yosoy2/prensa_gemela/fotos/Ensamble3.png

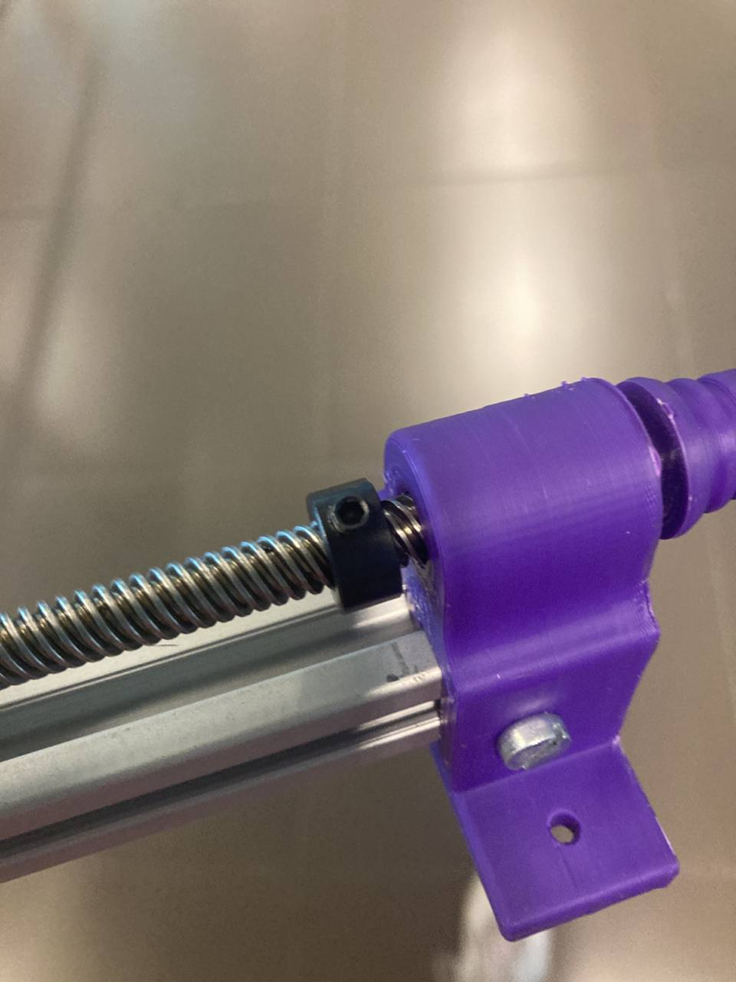
fotos/Ensamble3.png
