yosoy2/prensa_gemela/fotos/Ensamble.png

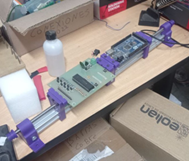
fotos/Ensamble.png
