yosoy2/prensa_gemela/fotos/Impresion1.png

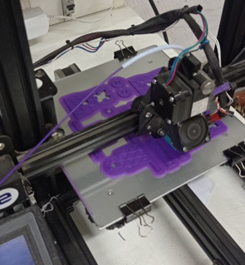
fotos/Impresion1.png
