yosoy2/prensa_gemela/fotos/Impresion2.png

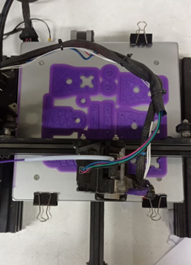
fotos/Impresion2.png
