yosoy2/prensa_gemela/fotos/prensa_gemela.PNG

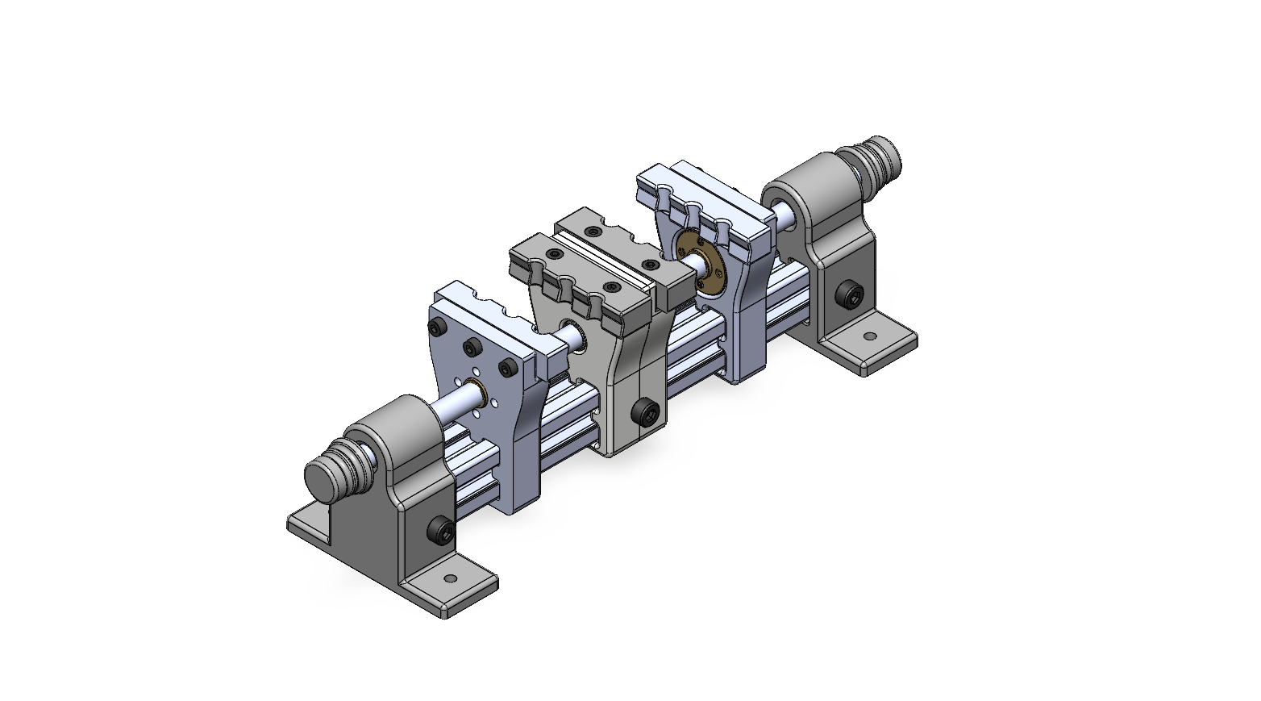
fotos/prensa_gemela.PNG
