yosoy2/prensa_gemela/fotos/prensa_gemela_grande.PNG

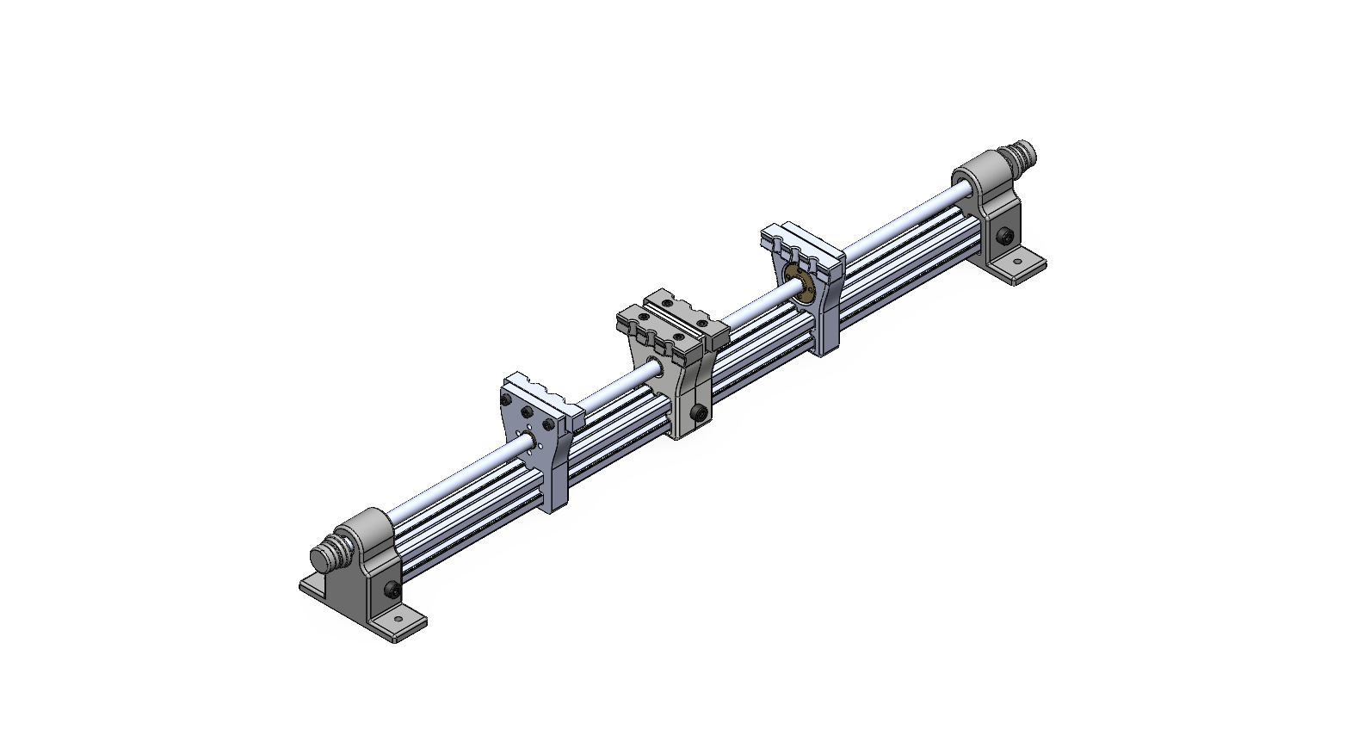
fotos/prensa_gemela_grande.PNG
