yosoy2/prensa_gemela/fotos/Programa segmentacion1.png

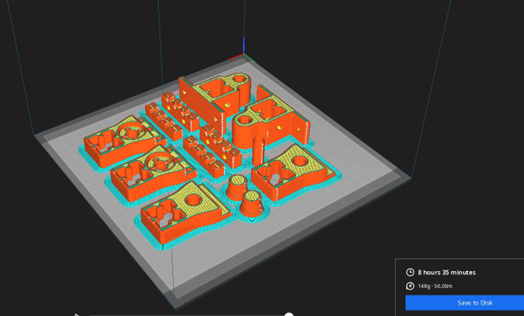
fotos/Programa segmentacion1.png
