yosoy2/prensa_gemela/fotos/Programa segmentación2.png

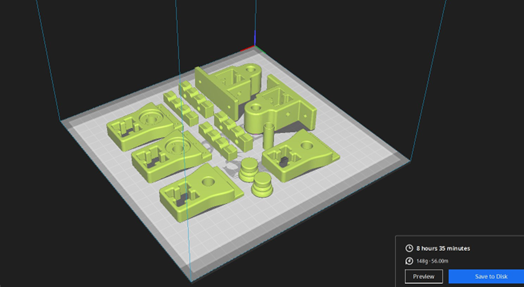
fotos/Programa segmentación2.png
