yosoy2/prensa_gemela/BOM.pdf

N.º DE ELEMENTO | N.º DE PIEZA | DESCRIPCIÓN | CANTIDAD
1 | perfil_guia | | 2
2 | Tornillo_tr8 | | 2
3 | 005359_Tuerca_de_lat ón_para_varilla_rosca da_husillo_Tr8_8_p2 | | 2
4 | mandibula_movil | | 2
5 | diente_2 | | 2
6 | mandibula_fija | | 2
7 | diente_2_fijo | | 2
8 | Base_Prensa | | 2
9 | buje | | 1
10 | Manivela | | 2
11 | M3_socket_10mm | | 6
12 | M3_socket_16mm | | 4
13 | M5_allen_socket_10m m | | 4
14 | T_Slot_Nut_Dropin_202 0 m5 v2 | | 4
15 | M5_allen_socket_45 | | 1
16 | M5_nut | | 1
