yosoy2/prensa_gemela/CAD/test.SLDASM

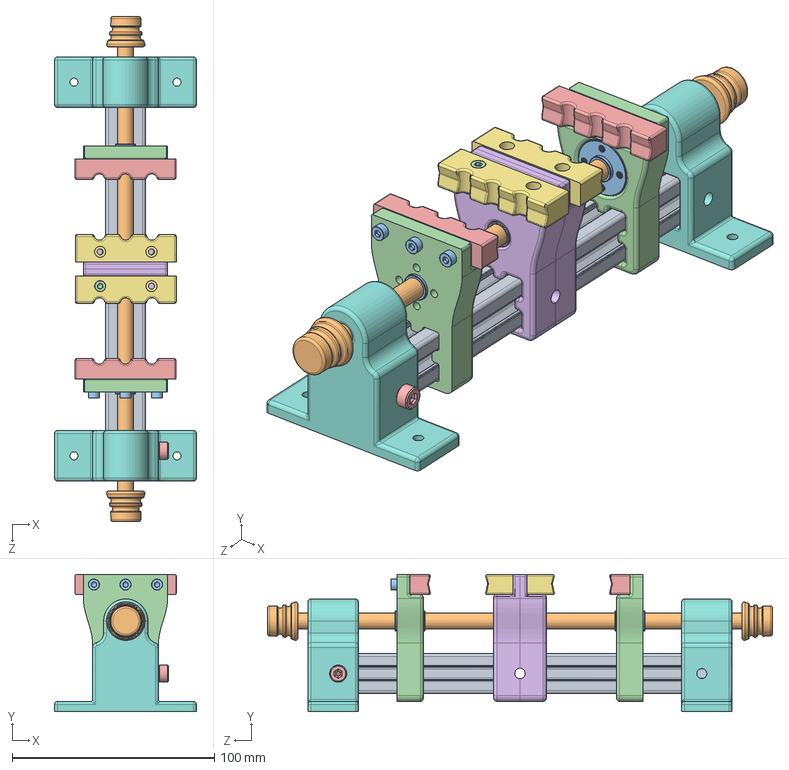
[picture p10: CAD file, 2022-12-02]
CAD/test.SLDASM
70.3 x 67.8 x 250.0 mm
perfil_guia x 2
Tornillo_tr8 x 2
005359_Tuerca_de_latón_para_varilla_roscada_husillo_Tr8_8_p2 x 2
mandibula_movil x 2
diente_2 x 2
mandibula_fija x 2
diente_2_fijo x 2
Base .step x 2
Buje_circular.step
Componente1.step x 2
M3_socket_10mm x 3
M3_socket_16mm
M5_allen_socket_10mm
T_Slot_Nut_Dropin_2020 m5 v2
