yosoy2/prensa_gemela/CAD/M3_socket_10mm.SLDPRT

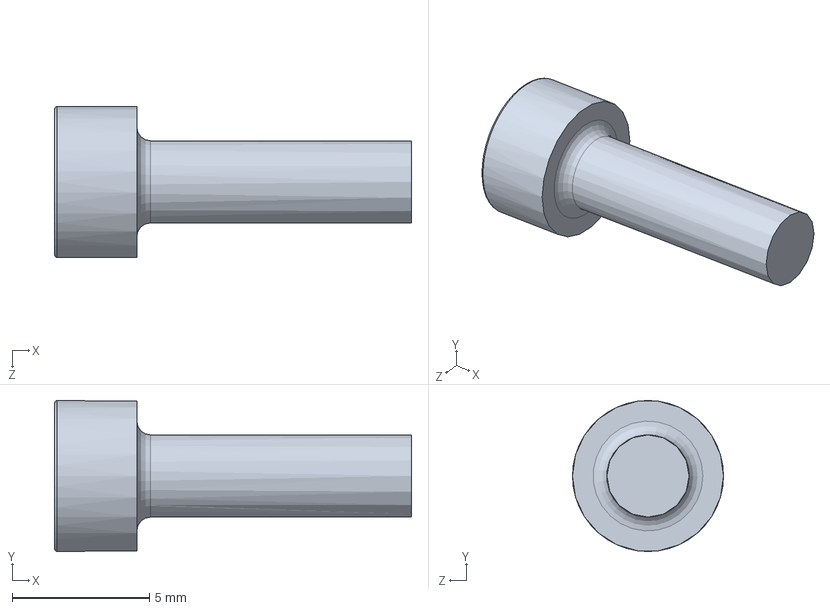
[picture p11: CAD file, 2022-12-02]
CAD/M3_socket_10mm.SLDPRT
13.0 x 5.50 x 5.50 mm
