yosoy2/prensa_gemela/para_impresion/diente_mandibula_fija.stl

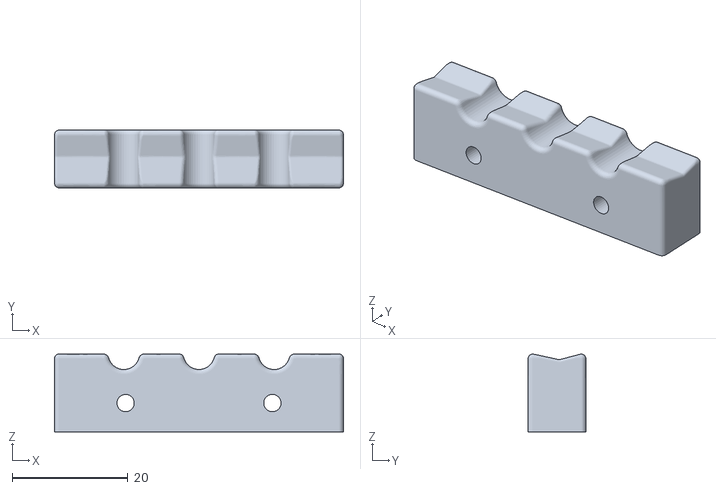
[picture p12: CAD file, 2022-12-02]
para_impresion/diente_mandibula_fija.stl
50.0 x 10.0 x 13.5
