yosoy2/prensa_gemela/step/perfil_guia.STEP

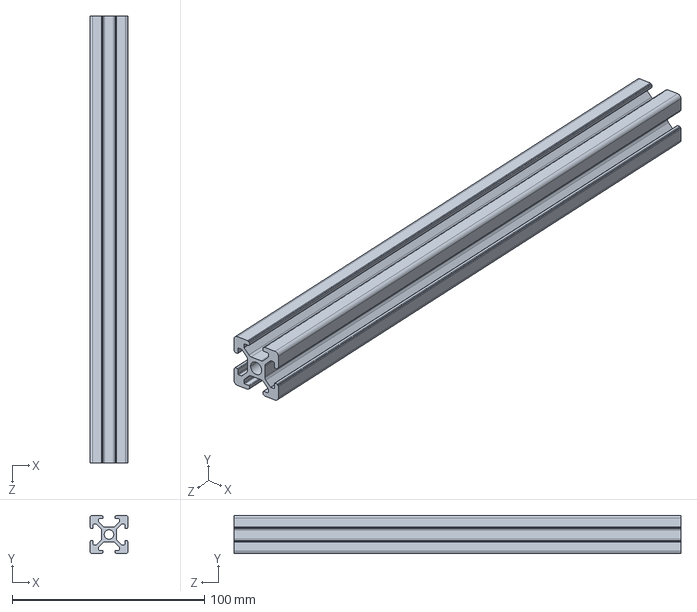
[picture p13: CAD file, 2022-12-02]
step/perfil_guia.STEP
20.0 x 20.0 x 232.5 mm
