yosoy2/prensa_gemela/test/test_buje.SLDPRT

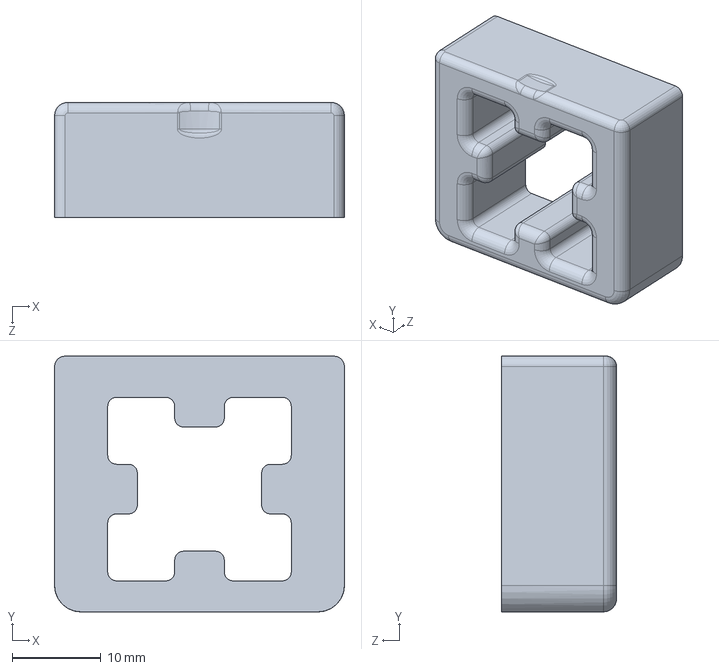
[picture p14: CAD file, 2022-12-02]
test/test_buje.SLDPRT
32.7 x 28.8 x 13.0 mm
