yosoy2/prensa_gemela/para_impresion/prensa_gemela.3mf

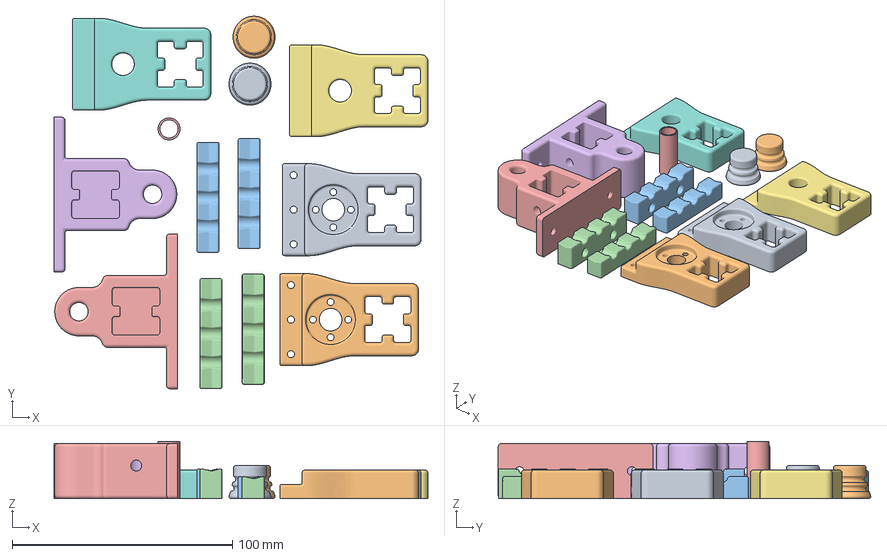
[picture p15: CAD file, 2022-12-02]
para_impresion/prensa_gemela.3mf
169.7 x 169.1 x 26.0 mm
mandibula_movil.STL
mandibula_movil.STL(1)
diente_2.STL
diente_2.STL(1)
Base Prensa_Base v1.stl
Base Prensa_Base v1.stl(1)
mandibula_fija_media.STL
mandibula_fija_media.STL(1)
Manivela v1.stl
Manivela v1.stl(1)
diente_mandibula_fija.stl
diente_mandibula_fija.stl(1)
buje_mandibula_fija.stl
