yosoy2/prensa_gemela/CAD/mandibula_movil.SLDPRT

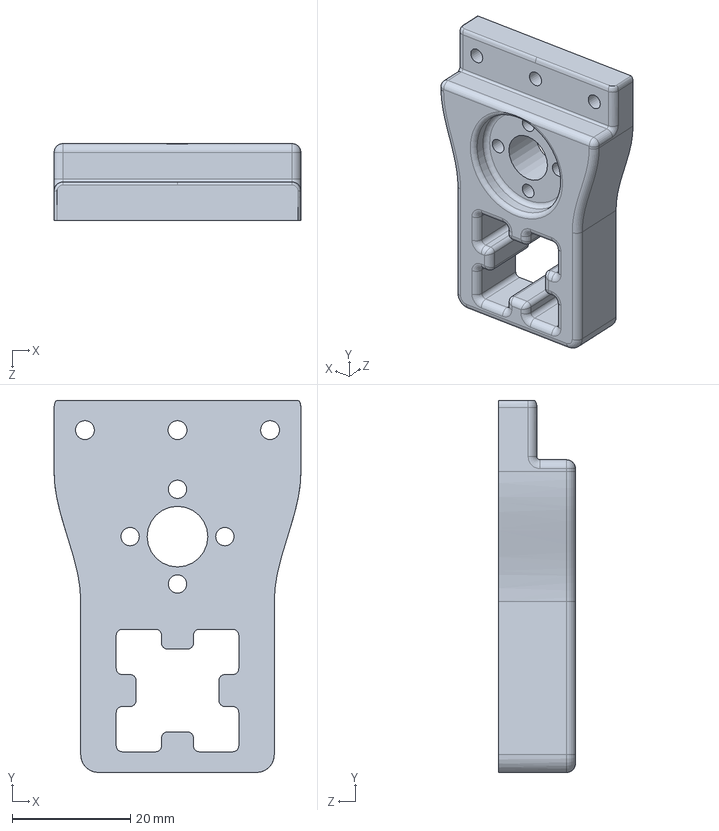
[picture p16: CAD file, 2022-12-02]
CAD/mandibula_movil.SLDPRT
41.7 x 62.8 x 13.0 mm
