yosoy2/prensa_gemela/para_impresion/Base Prensa_Base v1.stl

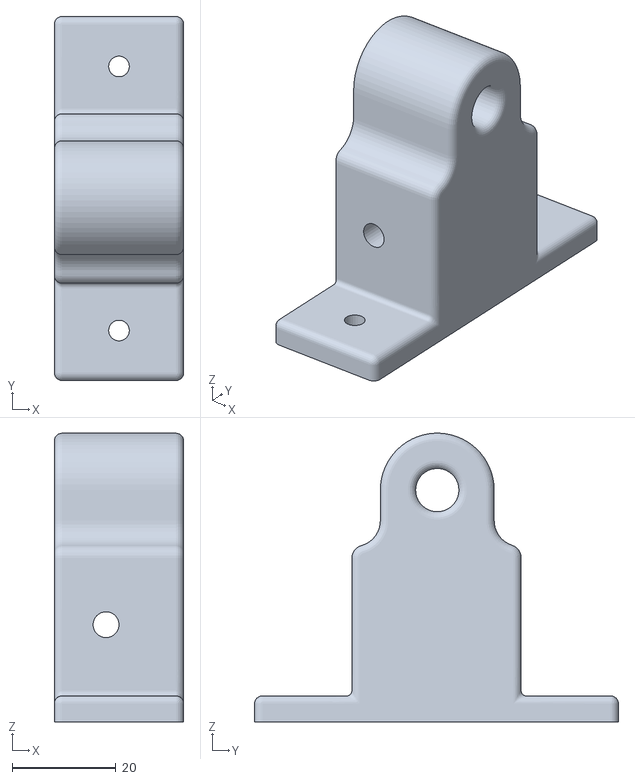
[picture p17: CAD file, 2022-12-02]
para_impresion/Base Prensa_Base v1.stl
25.0 x 70.3 x 55.7
