yosoy2/prensa_gemela/step/mandibula_movile.STEP

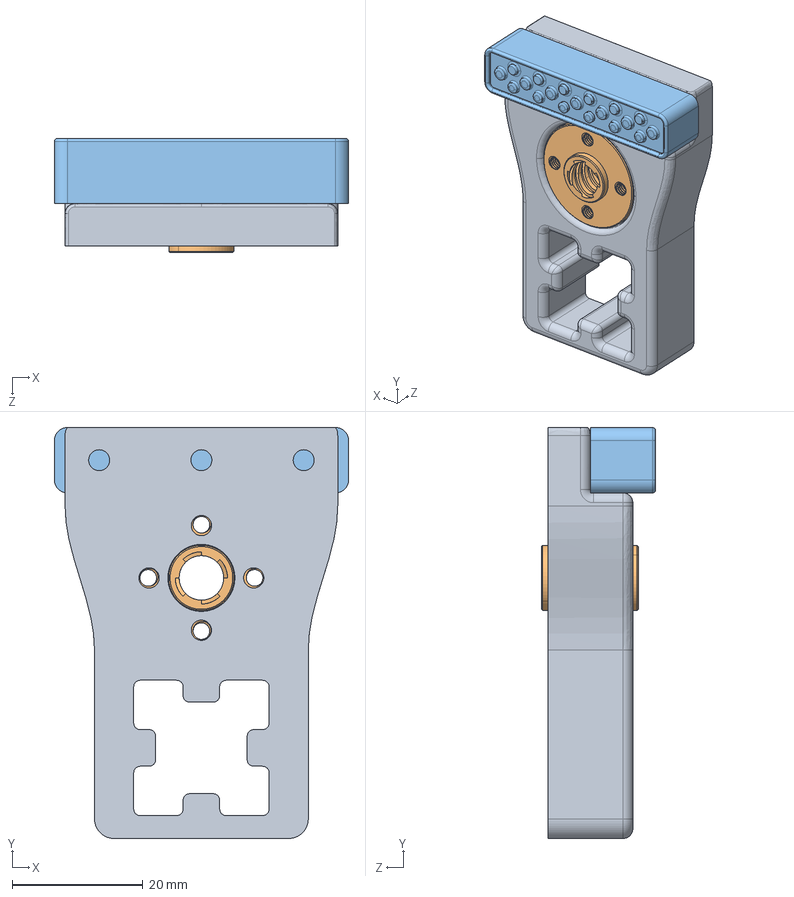
[picture p18: CAD file, 2022-12-02]
step/mandibula_movile.STEP
45.0 x 62.9 x 17.5 mm
mandibula_movil
005359_Tuerca_de_latón_para_varilla_roscada_husillo_Tr8_8_p2
diente_1
