yosoy2/prensa_gemela/step/M5_allen_socket_10mm.STEP

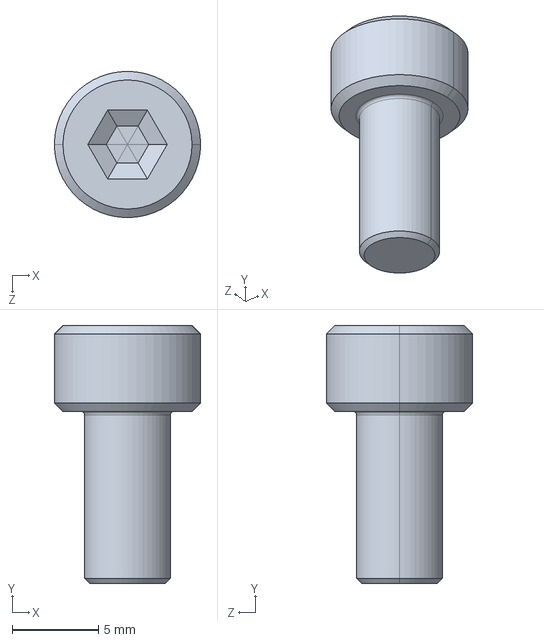
[picture p19: CAD file, 2022-12-02]
step/M5_allen_socket_10mm.STEP
8.50 x 15.0 x 8.50 mm
