yosoy2/prensa_gemela/para_impresion/diente_2.STL

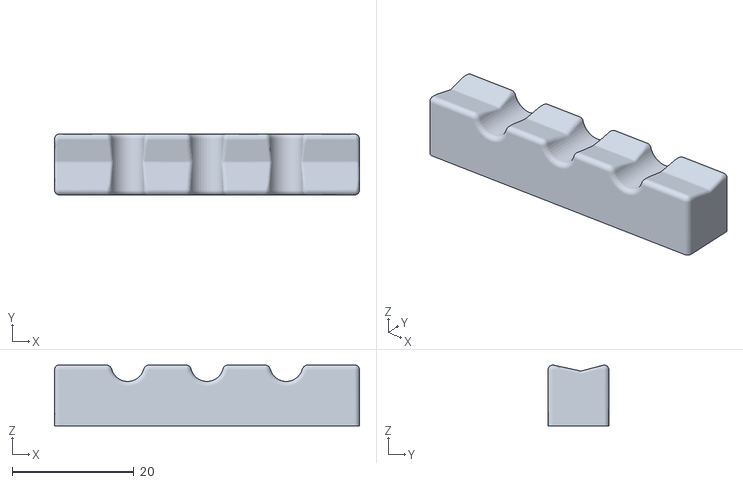
[picture p20: CAD file, 2022-12-02]
para_impresion/diente_2.STL
50.0 x 10.00 x 9.98
