yosoy2/prensa_gemela/CAD/diente_1.SLDPRT

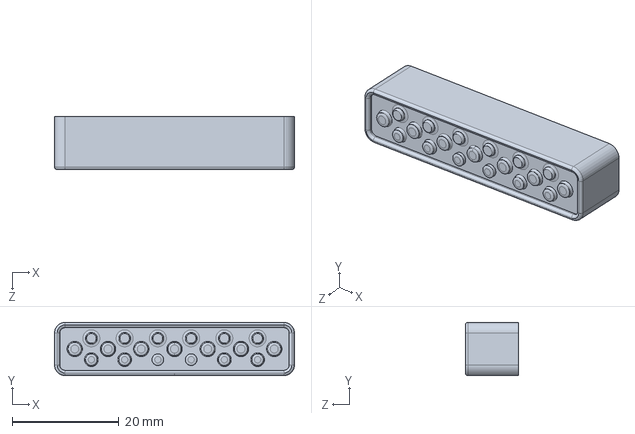
[picture p21: CAD file, 2022-12-02]
CAD/diente_1.SLDPRT
45.0 x 10.0 x 10.0 mm
