yosoy2/prensa_gemela/para_impresion/buje_mandibula_fija.stl

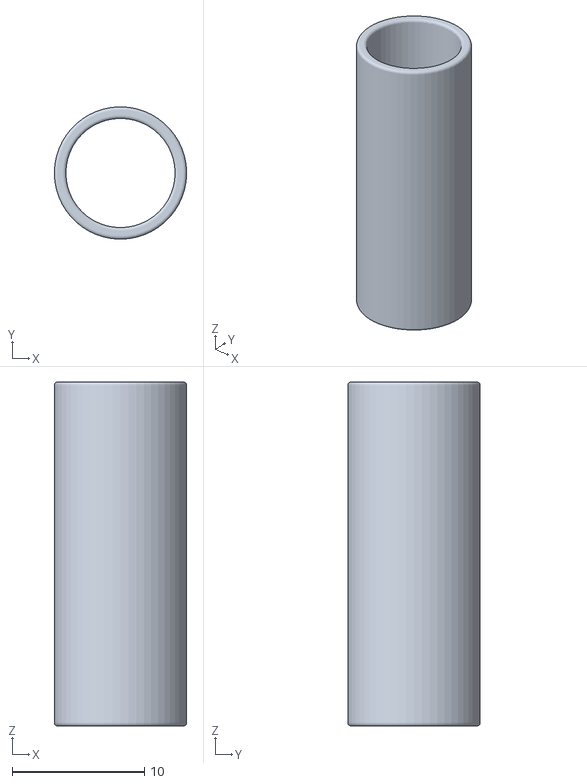
[picture p22: CAD file, 2022-12-02]
para_impresion/buje_mandibula_fija.stl
10.0 x 10.0 x 26.0
