yosoy2/prensa_gemela/para_impresion/Manivela v1.stl

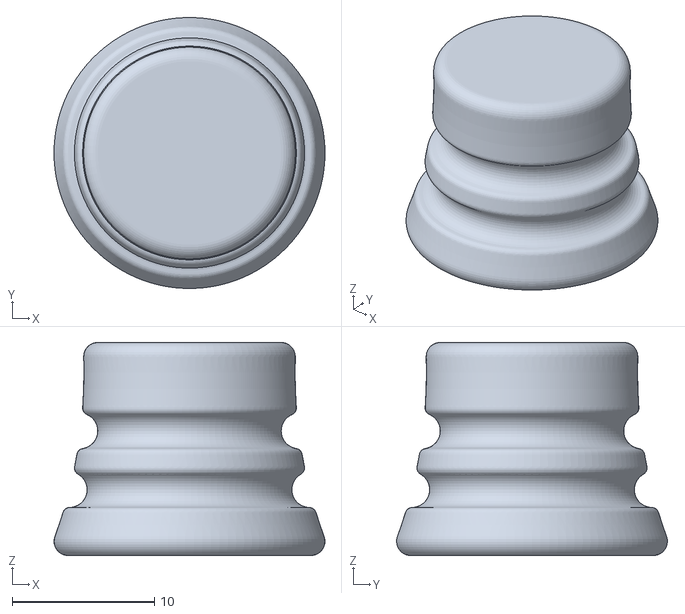
[picture p23: CAD file, 2022-12-02]
para_impresion/Manivela v1.stl
19.1 x 19.1 x 15.0
