yosoy2/prensa_gemela/para_impresion/mandibula_fija_media.STL

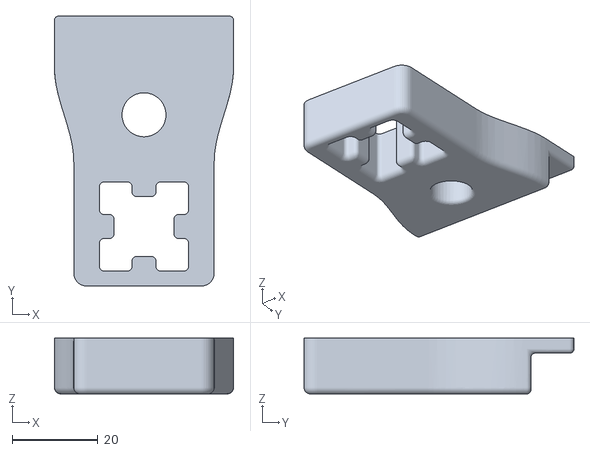
[picture p24: CAD file, 2022-12-02]
para_impresion/mandibula_fija_media.STL
41.7 x 62.8 x 13.0
