yosoy2/prensa_gemela/step/M5_allen_socket_45.STEP

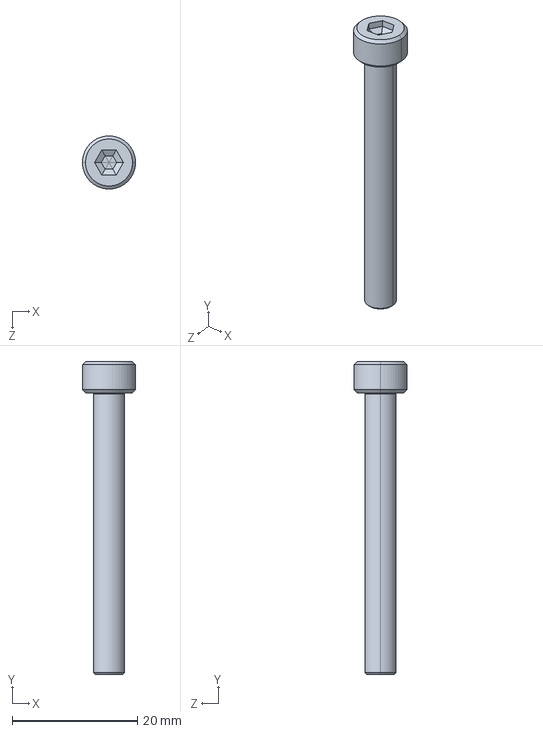
[picture p25: CAD file, 2022-12-02]
step/M5_allen_socket_45.STEP
8.50 x 50.0 x 8.50 mm
