yosoy2/prensa_gemela/step/Tornillo_tr8.STEP

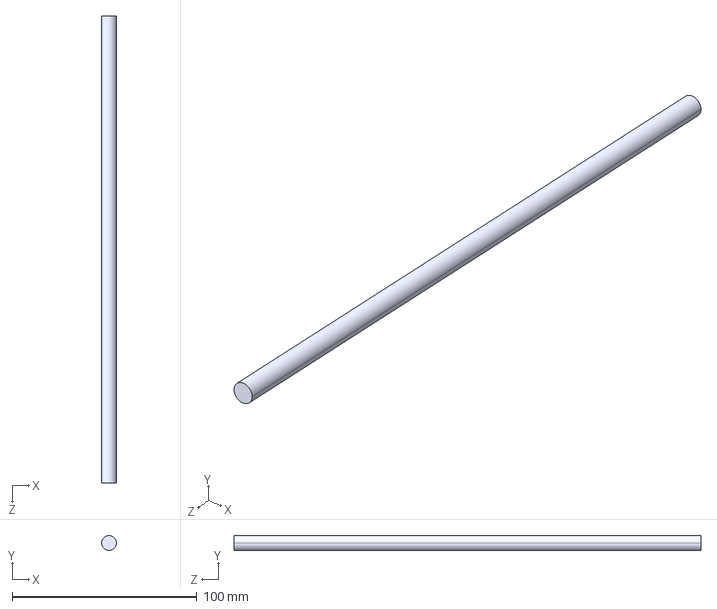
[picture p26: CAD file, 2022-12-02]
step/Tornillo_tr8.STEP
8.00 x 8.00 x 252.5 mm
