yosoy2/prensa_gemela/(list of files, cad)

Other CAD files:
step/M3_socket_16mm.STEP
para_impresion/test_buje.STL
step/Base_Prensa.step
step/diente_2.STEP
para_impresion/mandibula_movil.STL
step/Manivela.step
step/mandibula_fija.step
step/buje.step
step/diente_2_fijo.step
CAD/005359_Tuerca_de_latón_para_varilla_roscada_husillo_Tr8_8_p2.SLDPRT
CAD/Base_Prensa.SLDASM
CAD/M3_socket_16mm.SLDPRT
CAD/M5_allen_socket_10mm.SLDPRT
CAD/M5_allen_socket_45.SLDPRT
CAD/M5_nut.SLDPRT
CAD/Manivela.SLDASM
CAD/T_Slot_Nut_Dropin_2020 m5 v2.SLDPRT
CAD/Tornillo_tr8.SLDPRT
CAD/buje.SLDASM
CAD/diente_2.SLDPRT
CAD/diente_2_fijo.SLDPRT
CAD/mandibula_fija.SLDPRT
CAD/perfil_guia.SLDPRT
step/005359_Tuerca_de_latón_para_varilla_roscada_husillo_Tr8_8_p2.step
step/M5_nut.STEP
