yosoy2/prensa_gemela/(commit log)

2022-12-02 added SW CAD files
    [005359_Tuerca_de_latón_para_varilla_roscada_husillo_Tr8_8_p2.SLDPRT, Base_Prensa.SLDASM, M3_socket_10mm.SLDPRT, M3_socket_16mm.SLDPRT, M5_allen_socket_10mm.SLDPRT, M5_allen_socket_45.SLDPRT, M5_nut.SLDPRT, Manivela.SLDASM]
2022-12-02 printing files
    [Base Prensa_Base v1.stl, Manivela v1.stl, buje_mandibula_fija.stl, diente_2.STL, diente_mandibula_fija.stl, mandibula_fija_media.STL, mandibula_movil.STL, prensa_gemela.3mf]
2022-12-02 bushing test files
    [test_buje.SLDPRT]
2022-12-02 step files for any kind of software
    [005359_Tuerca_de_latón_para_varilla_roscada_husillo_Tr8_8_p2.step, Base_Prensa.step, M3_socket_16mm.STEP, M5_allen_socket_10mm.STEP, M5_allen_socket_45.STEP, M5_nut.STEP, Manivela.step, Tornillo_tr8.STEP]
